fotherja/Grid_Tie_Inverter_2/README.md

# Grid_Tie_Inverter_2
Version 2 of the GTI project

Here are the Eagle files for the grid tie inverter H-Bridge and voltage sense board.

And all the software that runs on and STM32f407 dev board.

Please see a full description of the project on instrucatbles
