fotherja/Grid_Tie_Inverter_2/Inverter_V_Sense/schematic_v2.brd

## EAGLE design Inverter_V_Sense/schematic_v2.brd (2021-06-01)

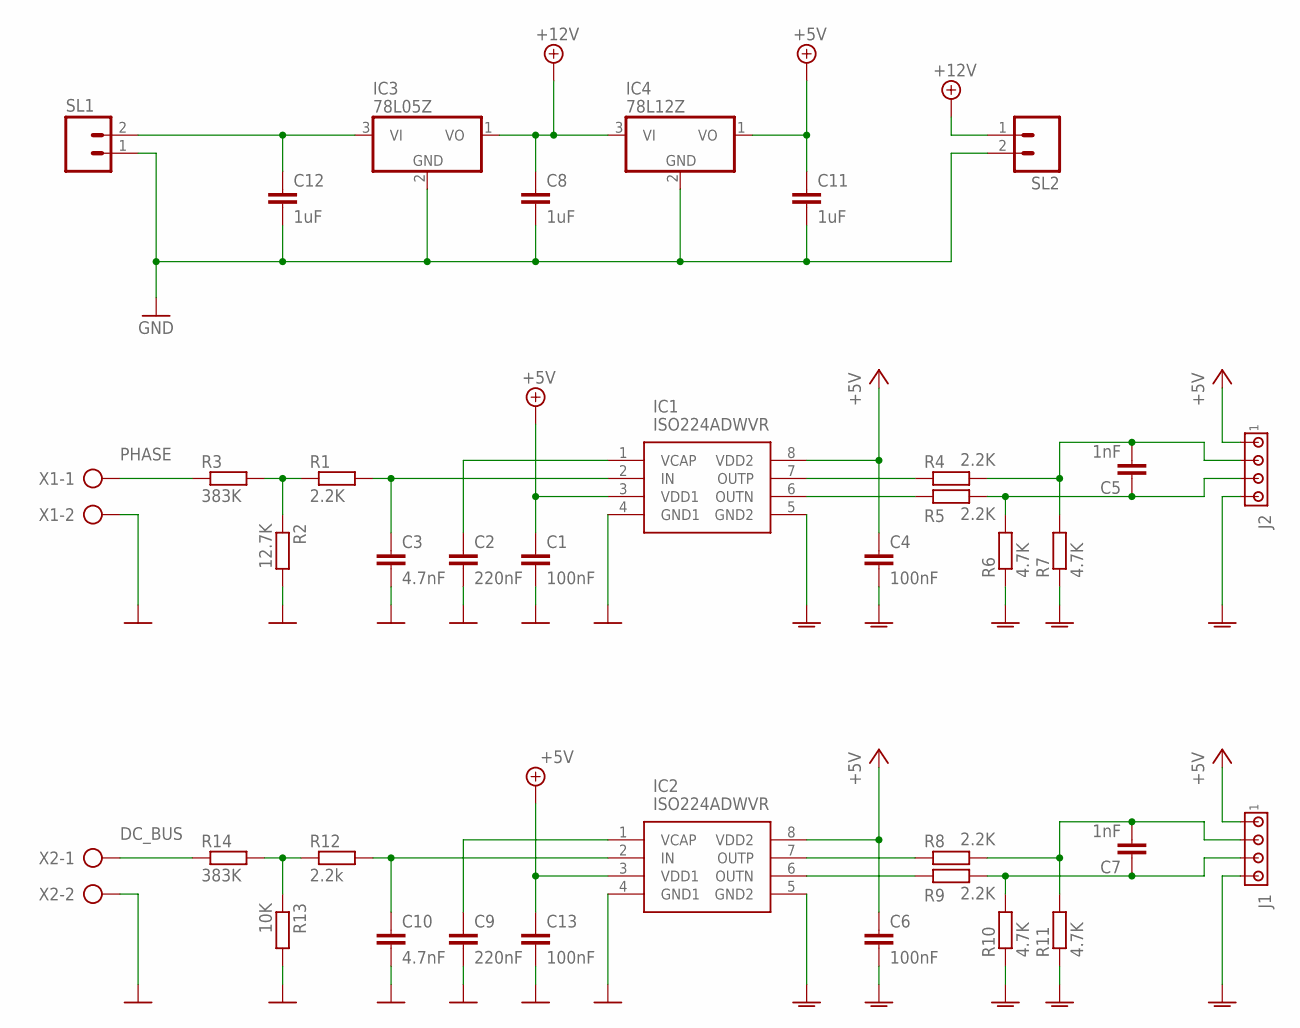
[picture p1: schematic schematic_v2.sch]

Parts:
C1, C4, C6, C13: 100nF; C0805
C2, C9: 220nF; C0805
C3, C10: 4.7nF; C0805
C5, C7: 1nF; C0805
C8, C11, C12: 1uF; C0805
IC1, IC2: ISO224ADWVR; SOIC127P1150X280-8N
IC3: 78L05Z; TO92
IC4: 78L12Z; TO92
J1, J2: MTA04-100; 10X04MTA
R1, R4, R5, R8, R9: 2.2K; R0805
R2: 12.7K; 0207/10
R3, R14: 383K; 0207/10
R6, R7, R10, R11: 4.7K; R0805
R12: 2.2k; R0805
R13: 10K; 0207/10
SL1, SL2: M02; 02P
X1, X2: AK500/2

Connections:
+5V: C1.1, C4.1, C6.1, C11.1, C13.1, IC1.3 (VDD1), IC1.8 (VDD2), IC2.3 (VDD1), IC2.8 (VDD2), IC4.1 (VO), J1.1, J2.1
+12V: C8.1, IC3.1 (VO), IC4.3 (VI), SL2.1
DC_BUS: R14.1, X2.1
GND: C1.2, C2.2, C3.2, C8.2, C9.2, C10.2, C11.2, C12.2, C13.2, IC1.4 (GND1), IC2.4 (GND1), IC3.2 (GND), IC4.2 (GND), R2.2, R13.2, SL1.1, SL2.2, X1.2, X2.2
GNDA: C4.2, C6.2, IC1.5 (GND2), IC2.5 (GND2), J1.4, J2.4, R6.1, R7.1, R10.1, R11.1
unnamed: C12.1, IC3.3 (VI), SL1.2
unnamed: C2.1, IC1.1 (VCAP)
unnamed: C3.1, IC1.2 (IN), R1.2
unnamed: R1.1, R2.1, R3.2
unnamed: IC2.7 (OUTP), R8.1
unnamed: IC1.7 (OUTP), R4.1
unnamed: IC1.6 (OUTN), R5.1
unnamed: C5.1, J2.3, R5.2, R6.2
unnamed: C5.2, J2.2, R4.2, R7.2
unnamed: IC2.6 (OUTN), R9.1
unnamed: C7.1, J1.3, R9.2, R10.2
unnamed: C7.2, J1.2, R8.2, R11.2
unnamed: C10.1, IC2.2 (IN), R12.2
unnamed: R12.1, R13.1, R14.2
unnamed: C9.1, IC2.1 (VCAP)
PHASE: R3.1, X1.1

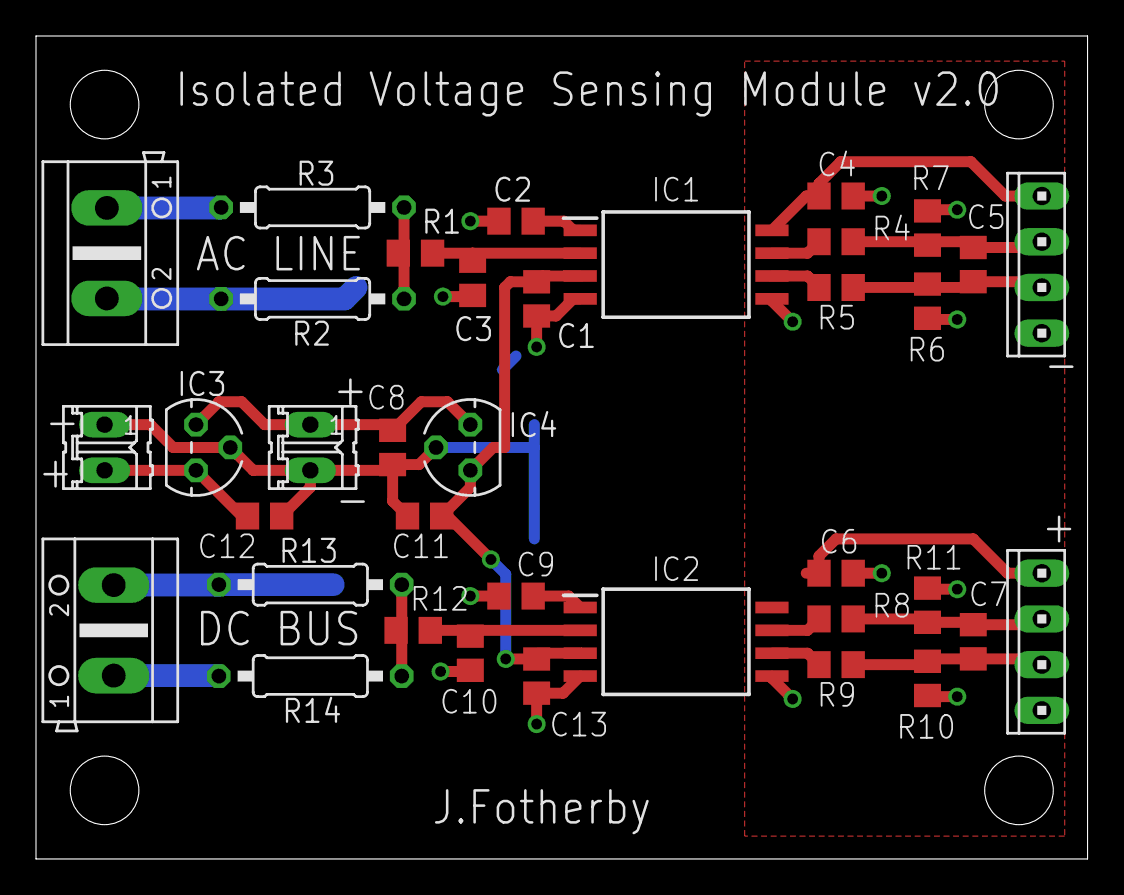
[picture p2: board schematic_v2.brd from above]

Board: 2 copper layers, 58.4 x 45.7 mm, 37 parts (0 on the bottom side), 21 nets.
