fotherja/Grid_Tie_Inverter_2/MicroInverter/Microinverter.brd

## EAGLE design MicroInverter/Microinverter.brd (2021-06-01)

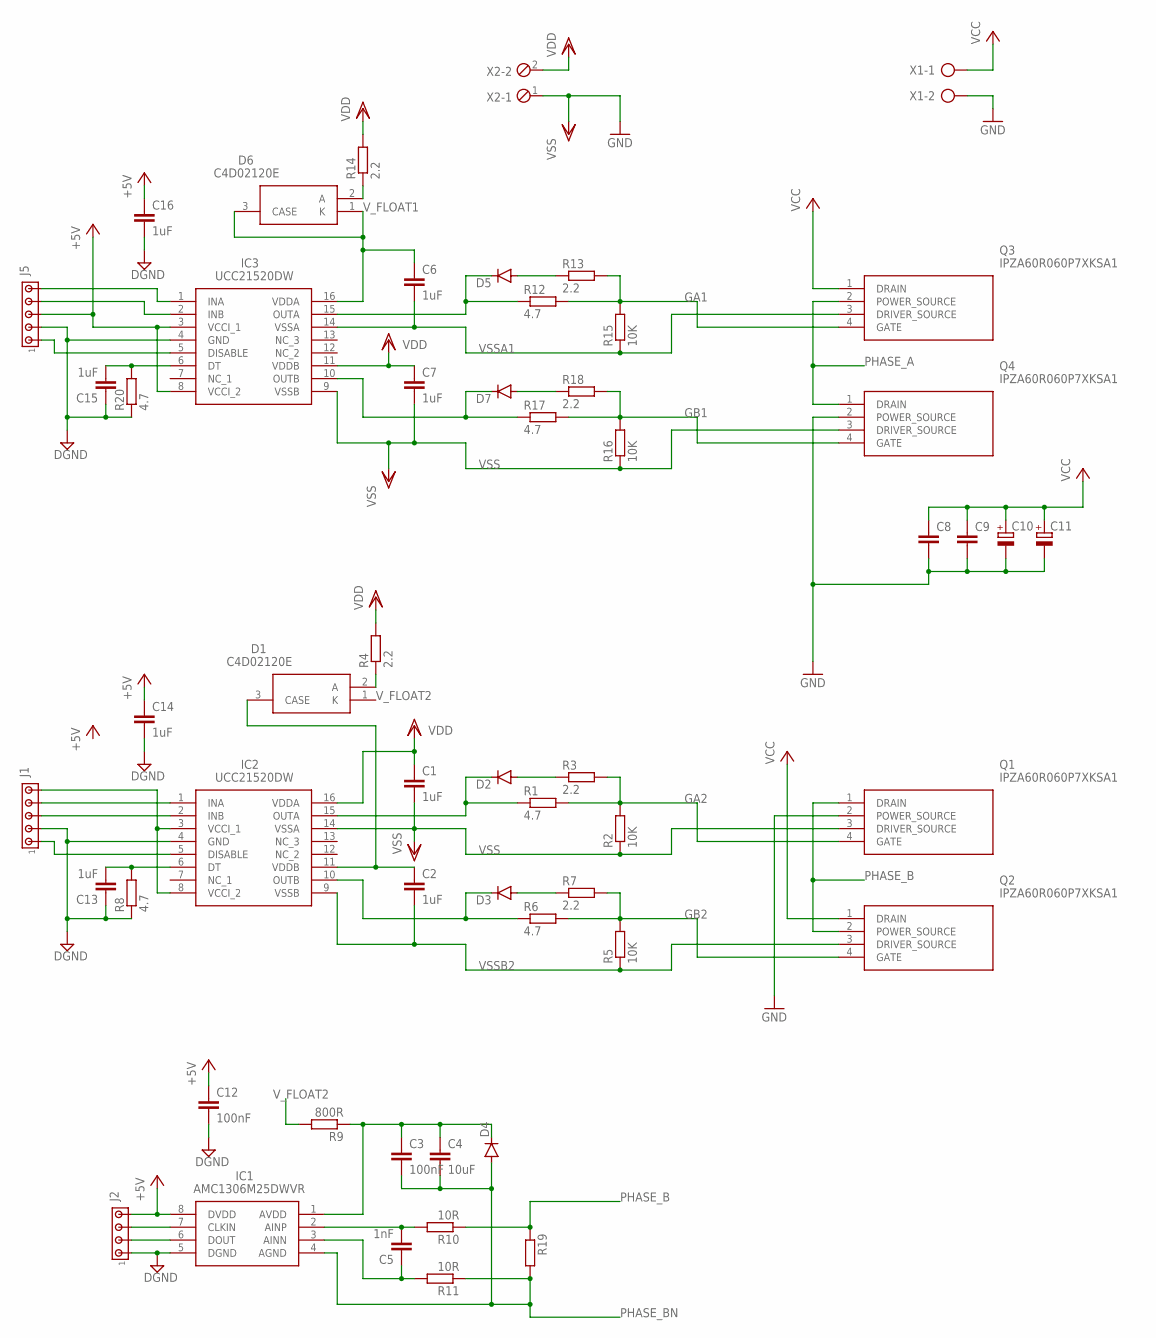
[picture p3: schematic Microinverter.sch]

Parts:
C1, C2, C6, C7, C13, C14, C15, C16: 1uF; C0805
C3, C12: 100nF; C0805
C4: 10uF; C0805
C5: 1nF; C0805
C8, C9: C-EUC1210K; C1210K
C10, C11: CPOL-EUSANYO_H; SANYO-OSCON_H
D1, D6: C4D02120E; C3D06065E
D2, D3, D4, D5, D7: MBR0520LT; SOD123
IC1: AMC1306M25DWVR; SOIC127P1150X280-8N
IC2, IC3: UCC21520DW; SOIC127P1030X265-16N
J1, J5: MTA05-100; 10X05MTA
J2: MTA04-100; 10X04MTA
Q1, Q2, Q3, Q4: IPZA60R060P7XKSA1
R1, R6, R8, R12, R17, R20: 4.7; R0805
R2, R5, R15, R16: 10K; R0805
R3, R4, R7, R13, R14, R18: 2.2; R0805
R9: 800R; R0805
R10, R11: 10R; R0805
R19: R-EU_R2512; R2512
X1: AK500/2
X2: MPT2; 2POL254

Connections:
+5V: C12.1, C14.1, C16.1, IC1.8 (DVDD), IC3.3 (VCCI_1), IC3.8 (VCCI_2), J2.4, J5.3
AVDD: C3.1, C4.1, D4.C, IC1.1 (AVDD), R9.1
CLKIN: IC1.7 (CLKIN), J2.3
DGND: C12.2, C13.1, C14.2, C15.1, C16.2, IC1.5 (DGND), IC2.4 (GND), IC3.4 (GND), J1.2, J2.1, J5.2, R8.1, R20.1
DOUT: IC1.6 (DOUT), J2.2
GA1: Q3.4 (GATE), R12.2, R13.2, R15.2
GA2: Q1.4 (GATE), R1.2, R2.2, R3.2
GB1: Q4.4 (GATE), R16.2, R17.2, R18.2
GB2: Q2.4 (GATE), R5.2, R6.2, R7.2
GND: C8.2, C9.2, C10.-, C11.-, Q1.2 (POWER_SOURCE), Q4.2 (POWER_SOURCE), X1.2
unnamed: D2.A, R3.1
unnamed: D3.A, R7.1
unnamed: C5.2, IC1.2 (AINP), R10.2
unnamed: D6.2 (A), R14.1
unnamed: D5.A, R13.1
unnamed: D7.A, R18.1
unnamed: D1.2 (A), R4.1
unnamed: C5.1, IC1.3 (AINN), R11.2
unnamed: IC2.1 (INA), J1.4
unnamed: C13.2, IC2.6 (DT), R8.2
unnamed: IC2.2 (INB), J1.3
unnamed: IC2.5 (DISABLE), J1.1
unnamed: C15.2, IC3.6 (DT), R20.2
unnamed: IC3.2 (INB), J5.4
unnamed: IC3.5 (DISABLE), J5.1
unnamed: IC2.3 (VCCI_1), IC2.8 (VCCI_2), J1.5
unnamed: IC3.1 (INA), J5.5
OUTA: D2.C, IC2.15 (OUTA), R1.1
OUTA1: D5.C, IC3.15 (OUTA), R12.1
OUTB1: D7.C, IC3.10 (OUTB), R17.1
P7: D3.C, IC2.10 (OUTB), R6.1
PHASE_A: Q3.2 (POWER_SOURCE), Q4.1 (DRAIN)
PHASE_B: Q1.1 (DRAIN), Q2.2 (POWER_SOURCE), R10.1, R19.1
PHASE_BN: C3.2, C4.2, D4.A, IC1.4 (AGND), R11.1, R19.2
VCC: C8.1, C9.1, C10.+, C11.+, Q2.1 (DRAIN), Q3.1 (DRAIN), X1.1
VDD: C1.1, C7.1, IC2.16 (VDDA), IC3.11 (VDDB), R4.2, R14.2, X2.2
VSS: C1.2, C7.2, IC2.14 (VSSA), IC3.9 (VSSB), Q1.3 (DRIVER_SOURCE), Q4.3 (DRIVER_SOURCE), R2.1, R16.1, X2.1
VSSA1: C6.2, IC3.14 (VSSA), Q3.3 (DRIVER_SOURCE), R15.1
VSSB2: C2.2, IC2.9 (VSSB), Q2.3 (DRIVER_SOURCE), R5.1
V_FLOAT1: C6.1, D6.1 (K), D6.3 (CASE), IC3.16 (VDDA)
V_FLOAT2: C2.1, D1.3 (CASE), IC2.11 (VDDB), R9.2

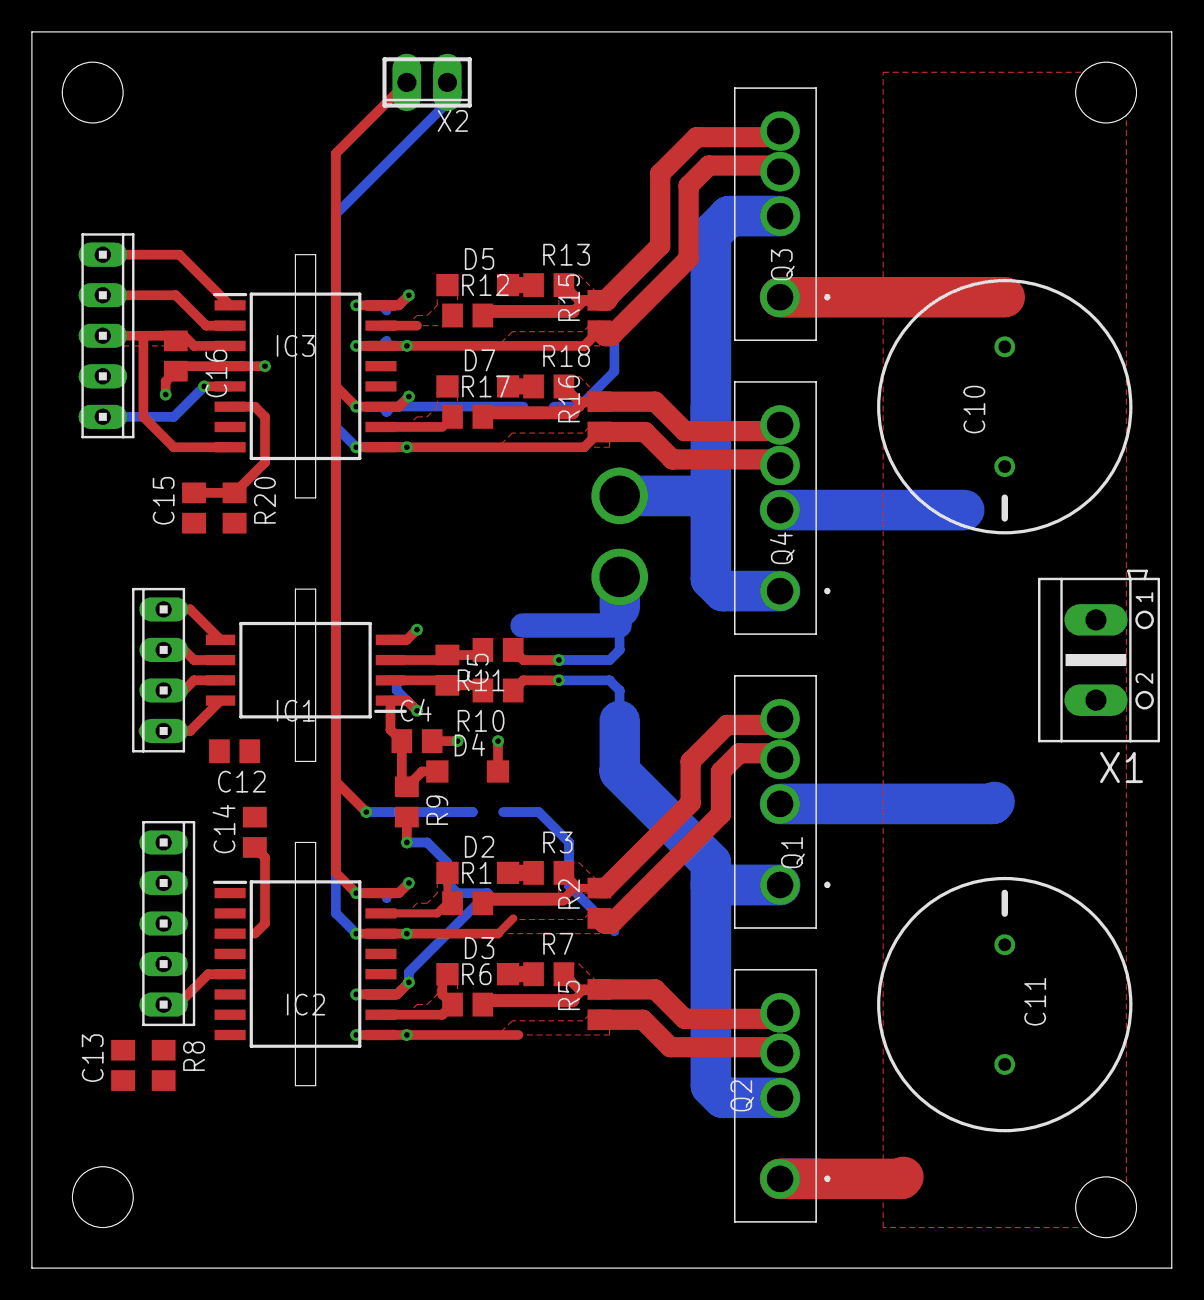
[picture p4: board Microinverter.brd from above]

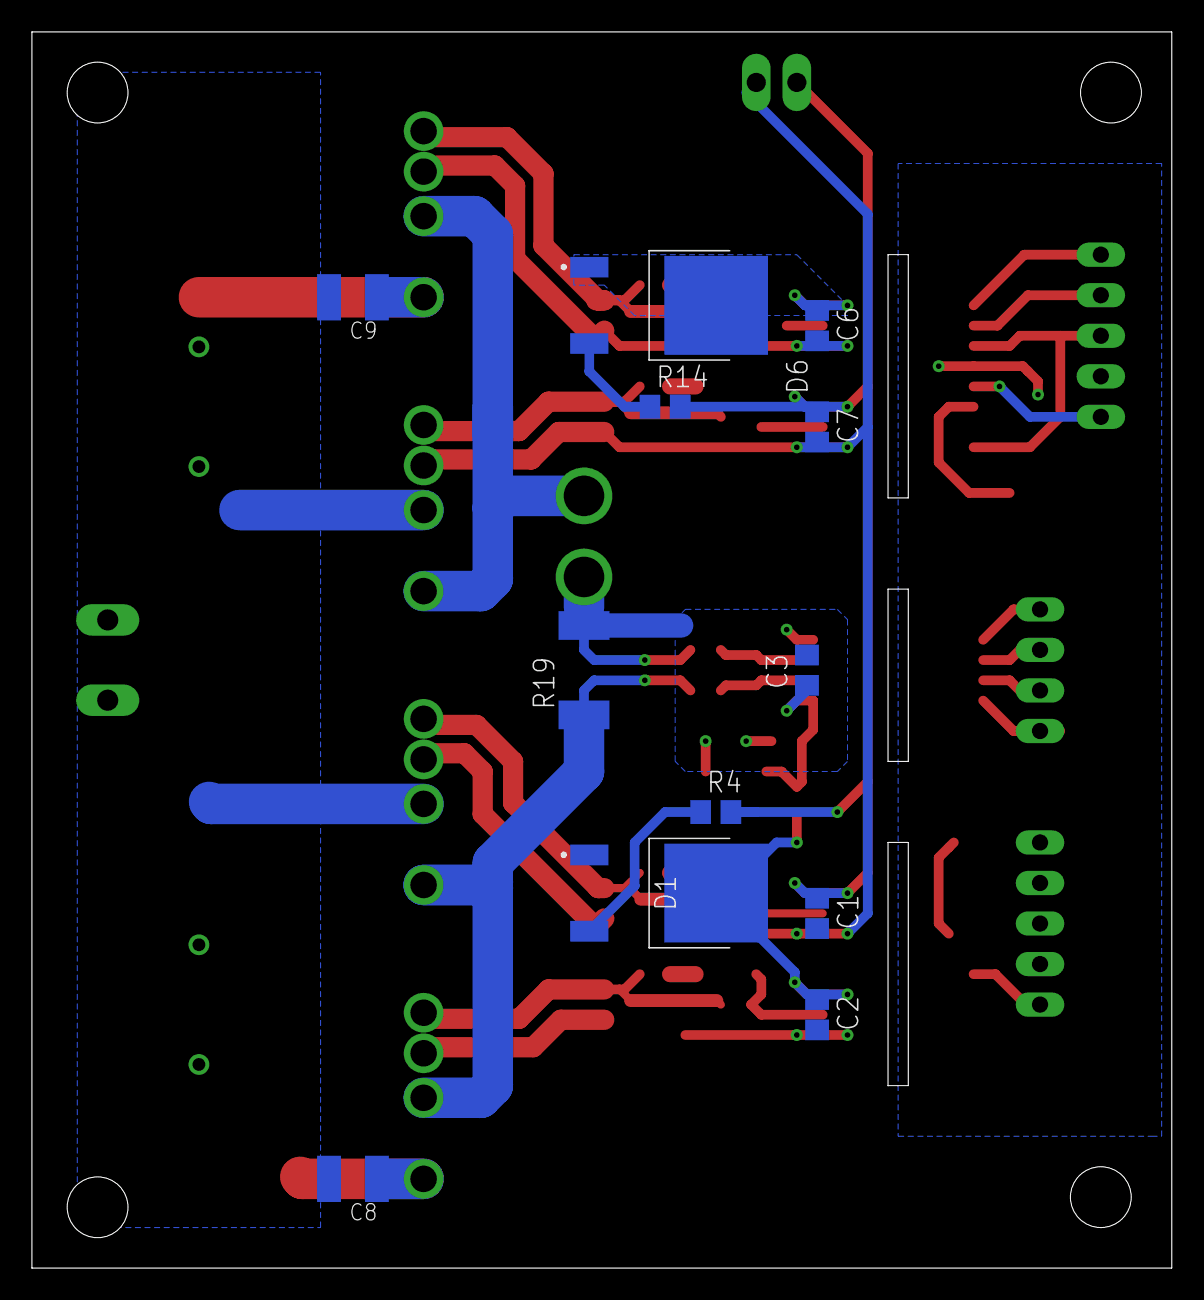
[picture p5: board Microinverter.brd from below]

Board: 2 copper layers, 71.4 x 77.5 mm, 55 parts (12 on the bottom side), 41 nets.
