fotherja/Grid_Tie_Inverter_2/GTI_Separate_Files.ioc

Mcu.UserName=STM32F407VGTx
PA4.GPIO_Label=DAC_Out
PA4.Signal=COMP_DAC1_group
PA7.GPIO_Label=Ph_AN_PWM
PA7.Signal=TIM1_CH1N
PB0.GPIO_Label=Ph_BN_PWM
PB0.Signal=TIM1_CH2N
PC0.GPIO_Label=Line_V_P
PC0.Signal=ADCx_IN10
PC1.GPIO_Label=Line_V_N
PC1.Signal=ADCx_IN11
PC10.Signal=SPI3_SCK
PC11.Signal=SPI3_MISO
PC2.GPIO_Label=DC_Bus_P
PC2.Signal=ADCx_IN12
PC3.GPIO_Label=DC_Bus_N
PC3.Signal=ADCx_IN13
PE11.GPIO_Label=Ph_B_PWM
PE11.Signal=S_TIM1_CH2
PE9.GPIO_Label=Ph_A_PWM
PE9.Signal=S_TIM1_CH1
PH0-OSC_IN.Signal=RCC_OSC_IN
PH1-OSC_OUT.Signal=RCC_OSC_OUT
