fotherja/Grid_Tie_Inverter_2/Inc/main.h

#define Line_V_P_Pin GPIO_PIN_0
#define Line_V_P_GPIO_Port GPIOC
#define Line_V_N_Pin GPIO_PIN_1
#define Line_V_N_GPIO_Port GPIOC
#define DC_Bus_P_Pin GPIO_PIN_2
#define DC_Bus_P_GPIO_Port GPIOC
#define DC_Bus_N_Pin GPIO_PIN_3
#define DC_Bus_N_GPIO_Port GPIOC
#define DAC_Out_Pin GPIO_PIN_4
#define DAC_Out_GPIO_Port GPIOA
#define Ph_AN_PWM_Pin GPIO_PIN_7
#define Ph_AN_PWM_GPIO_Port GPIOA
#define Ph_BN_PWM_Pin GPIO_PIN_0
#define Ph_BN_PWM_GPIO_Port GPIOB
#define Ph_A_PWM_Pin GPIO_PIN_9
#define Ph_A_PWM_GPIO_Port GPIOE
#define Ph_B_PWM_Pin GPIO_PIN_11
#define Ph_B_PWM_GPIO_Port GPIOE
